RWeick/REF1256-N64-GameBooster-Clone/REF1256 Clone.kicad_pcb

## KiCad design REF1256 Clone.kicad_pcb (2024-07-02)

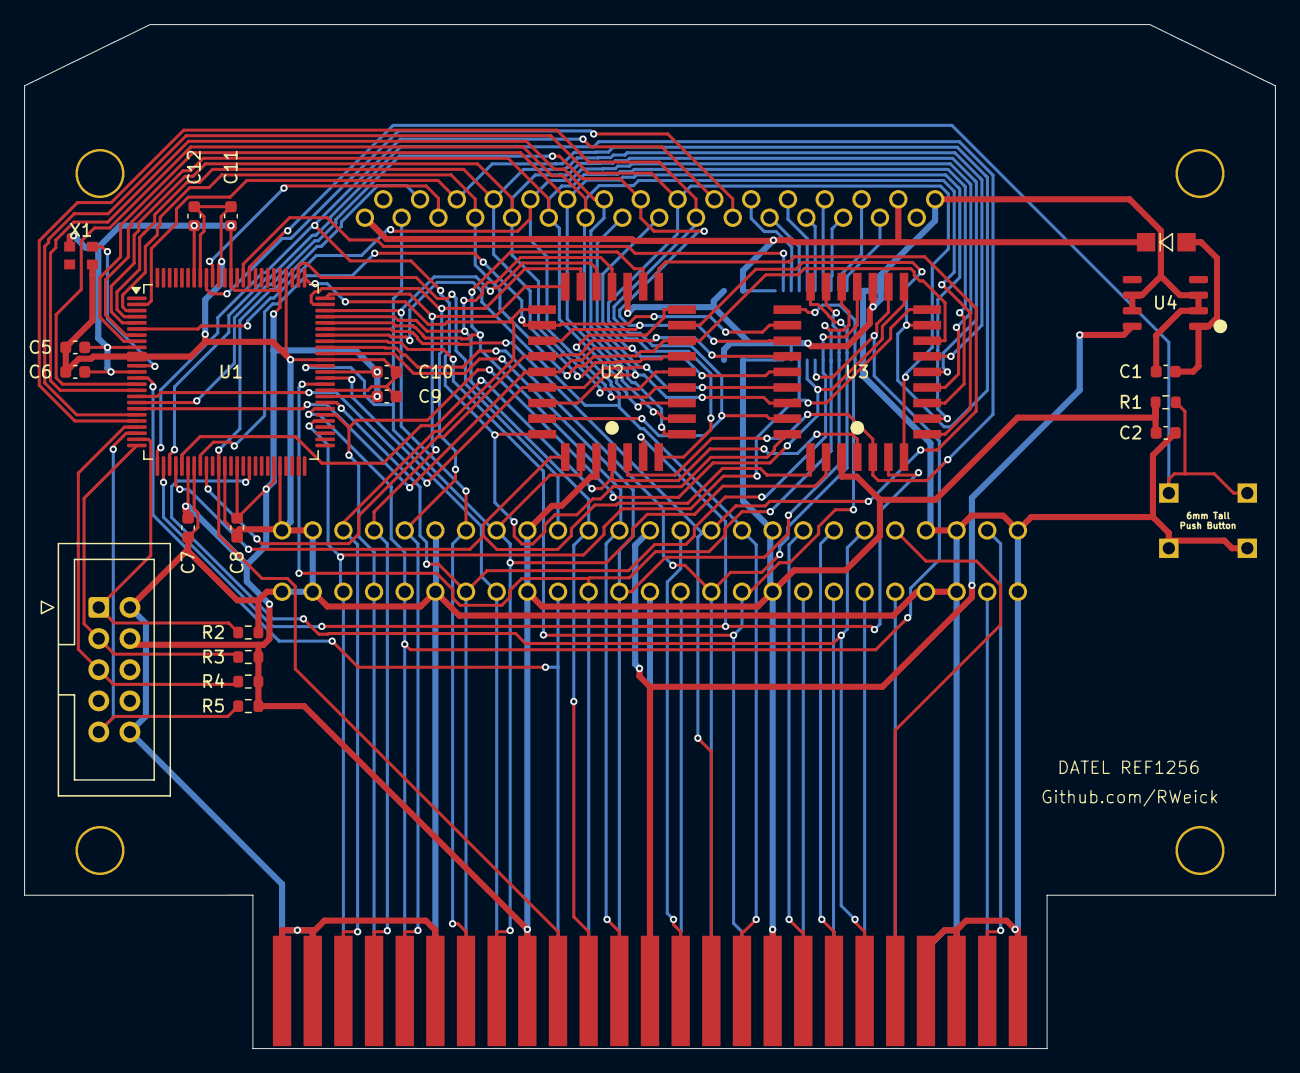
[picture p2: board REF1256 Clone.kicad_pcb from above]

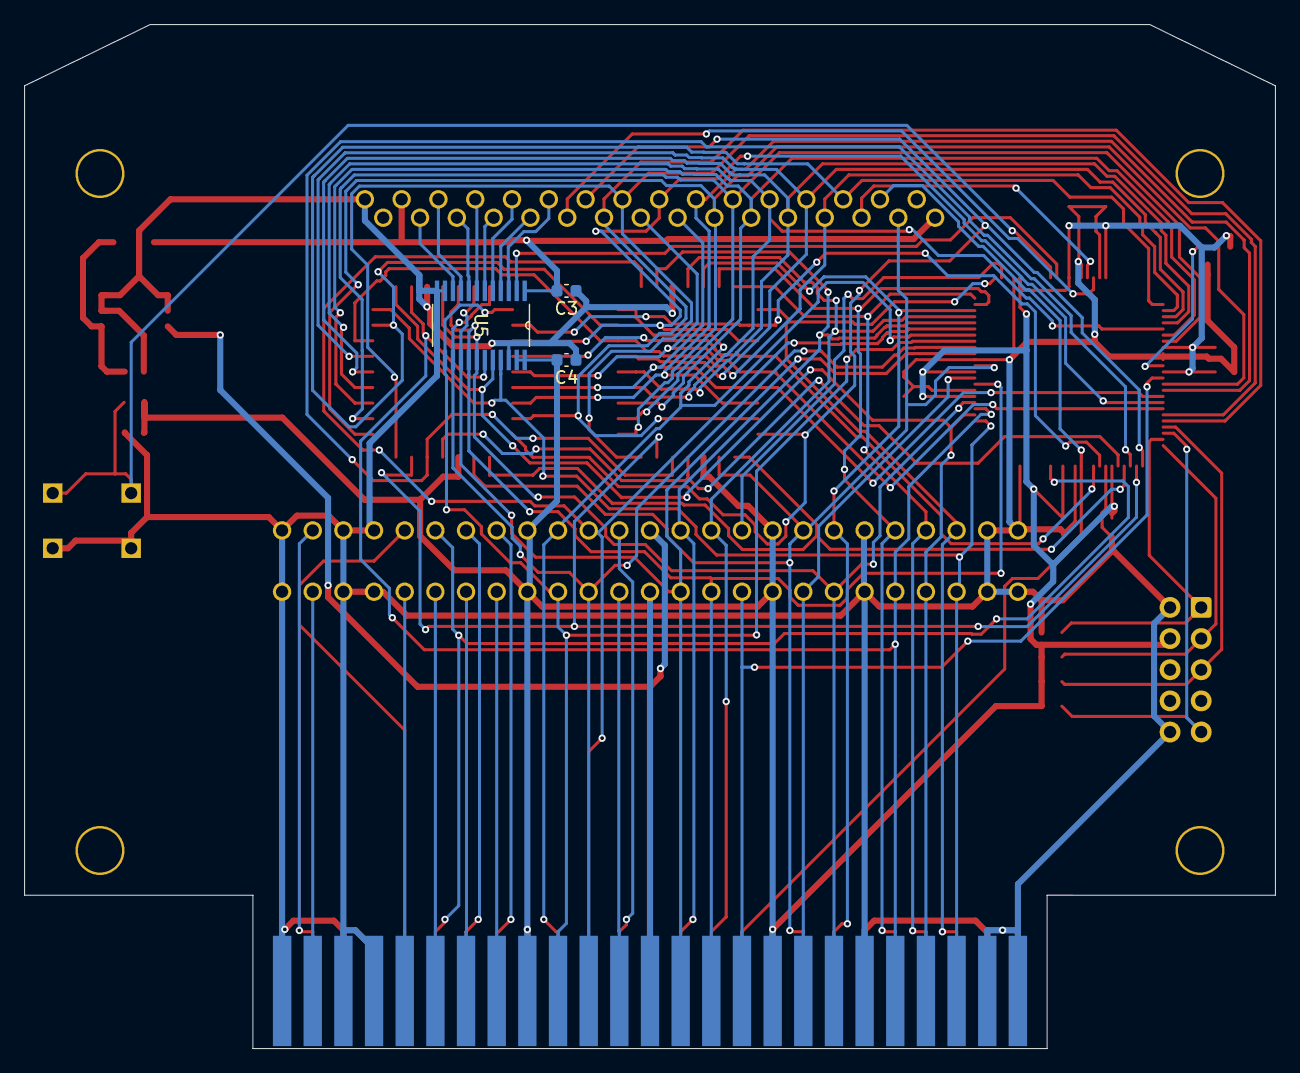
[picture p3: board REF1256 Clone.kicad_pcb from below]

Board: 2 copper layers, 102.0 x 83.5 mm, 30 parts (3 on the bottom side), 77 nets.

Parts:
C1, C2, C5, C6, C7, C8, C9, C10, C11, C12: 100 nF; C_0603_1608Metric
C3, C4: 100n; C_0603_1608Metric
D1: D_Small; Diode
Holes: Drill Holes
J1: Gameboy Cartridge Connector; Gameboy Slot
J2: N64 Cartridge Slot; Cartridge Slot
J3: Edge_Connector; Bottom Edge Connector
J4: Conn_02x05_Odd_Even; IDC-Header_2x05_P2.54mm_Vertical
R1, R2, R3, R4, R5: 10K Ohm; R_0603_1608Metric
SW1: SW_Push; 6mm Push Button
U1: EPM570T100; LQFP-100_14x14mm_P0.5mm
U2, U3: SST28LF040; PLCC32
U4: LM78L05_SO8; LM7805
U5: SN74LVC4245A
X1: ASCO; 50 MHz Crystal

Connections:
+3V3: C2.1, C4.2, C5.2, C6.2, C7.2, C8.2, C9.1, C10.1, C11.1, C12.1, J2.9 (3.3V), J2.17 (3.3V), J2.34 (3.3V), J2.42 (3.3V), J3.9 (3.3V), J3.17 (3.3V), J3.34 (3.3V), J3.42 (3.3V), J4.4, R1.1, R3.2, R4.2, R5.2, U1.9 (VCCIO1), U1.13 (VCCINT), U1.31 (VCCIO1), U1.39 (VCCINT), U1.45 (VCCIO1), U1.59 (VCCIO2), U1.63 (VCCINT), U1.80 (VCCIO2), U1.88 (VCCINT), U1.94 (VCCIO2), U2.32 (VCC), U3.32 (VCC), U5.23 (VCCB), U5.24 (VCCB), X1.4 (VDD)
/5V.VCC: C3.2, D1.1 (K), J1.1 (+5V), J1.30 (Reset), U5.1 (VCCA)
/5V.VOUT: C1.2, D1.2 (A), U4.1 (OUT)
/12V_Front: J2.13 (12V), J3.13 (12V), U4.8 (IN)
/12V_Rear: J2.38 (12V), J3.38 (12V)
/A0: J1.6 (A0), U1.2 (IO1_2), U2.12 (A0), U3.12 (A0)
/A1: J1.7 (A1), U1.3 (IO1_3), U2.11 (A1), U3.11 (A1)
/A2: J1.8 (A2), U1.4 (IO1_4), U2.10 (A2), U3.10 (A2)
/A3: J1.9 (A3), U1.5 (IO1_5), U2.9 (A3), U3.9 (A3)
/A4: J1.10 (A4), U1.6 (IO1_6), U2.8 (A4), U3.8 (A4)
/A5: J1.11 (A5), U1.7 (IO1_7), U2.7 (A5), U3.7 (A5)
/A6: J1.12 (A6), U1.8 (IO1_8), U2.6 (A6), U3.6 (A6)
/A7: J1.13 (A7), U1.15 (IO1_15), U2.5 (A7), U3.5 (A7)
/A8: J1.14 (A8), U1.16 (IO1_16), U2.27 (A8), U3.27 (A8)
/A9: J1.15 (A9), U1.17 (IO1_17), U2.26 (A9), U3.26 (A9)
/A10: J1.16 (A10), U1.18 (IO1_18), U2.23 (A10), U3.23 (A10)
/A11: J1.17 (A11), U1.19 (IO1_19), U2.25 (A11), U3.25 (A11)
/A12: J1.18 (A12), U1.20 (IO1_20), U2.4 (A12), U3.4 (A12)
/A13: J1.19 (A13), U1.21 (IO1_21), U2.28 (A13), U3.28 (A13)
/A14: J1.20 (A14), U1.26 (IO1_26), U2.29 (A14), U3.29 (A14)
/A15: U1.27 (IO1_27), U2.3 (A15), U3.3 (A15)
/A16: U1.28 (IO1_28), U2.2 (A16), U3.2 (A16)
/A17: U1.29 (IO1_29), U2.30 (A17), U3.30 (A17)
/A18: U1.30 (IO1_30), U2.1 (A18), U3.1 (A18)
/AD0: J2.28 (AD0), J3.28 (AD0), U1.55 (IO2_55), U3.13 (Ad8), U5.21 (B1)
/AD0.5V: J1.22 (Data_0), U5.3 (A1)
/AD1: J2.29 (AD1), J3.29 (AD1), U1.56 (IO2_56), U3.14 (Ad9), U5.20 (B2)
/AD1.5V: J1.23 (Data_1), U5.4 (A2)
/AD2: J2.30 (AD2), J3.30 (AD2), U1.57 (IO2_57), U3.15 (Ad10), U5.19 (B3)
/AD2.5V: J1.24 (Data_2), U5.5 (A3)
/AD3: J2.32 (AD3), J3.32 (AD3), U1.58 (IO2_58), U3.17 (Ad11), U5.18 (B4)
/AD3.5V: J1.25 (Data_3), U5.6 (A4)
/AD4: J2.36 (AD4), J3.36 (AD4), U1.61 (IO2_61), U3.18 (Ad12), U5.17 (B5)
/AD4.5V: J1.26 (Data_4), U5.7 (A5)
/AD5: J2.37 (AD5), J3.37 (AD5), U1.66 (IO2_66), U3.19 (Ad13), U5.16 (B6)
/AD5.5V: J1.27 (Data_5), U5.8 (A6)
/AD6: J2.40 (AD6), J3.40 (AD6), U1.67 (IO2_67), U3.20 (Ad14), U5.15 (B7)
/AD6.5V: J1.28 (Data_6), U5.9 (A7)
/AD7: J2.41 (AD7), J3.41 (AD7), U1.68 (IO2_68), U3.21 (Ad15), U5.14 (B8)
/AD7.5V: J1.29 (Data_7), U5.10 (A8)
/AD8: J2.16 (AD8), J3.16 (AD8), U1.69 (IO2_69), U2.13 (Ad0)
/AD9: J2.15 (AD9), J3.15 (AD9), U1.70 (IO2_70), U2.14 (Ad1)
/AD10: J2.12 (AD10), J3.12 (AD10), U1.71 (IO2_71), U2.15 (Ad2)
/AD11: J2.11 (AD11), J3.11 (AD11), U1.72 (IO2_72), U2.17 (Ad3)
/AD12: J2.7 (AD12), J3.7 (AD12), U1.73 (IO2_73), U2.18 (Ad4)
/AD13: J2.5 (AD13), J3.5 (AD13), U1.74 (IO2_74), U2.19 (Ad5)
/AD14: J2.4 (AD14), J3.4 (AD14), U1.75 (IO2_75), U2.20 (Ad6)
/AD15: J2.3 (AD15), J3.3 (AD15), U1.76 (IO2_76), U2.21 (Ad7)
/ALE_H: J2.35 (ALE_H), J3.35 (ALE_H), U1.14 (IO1_14/GCLK1)
/ALE_L: J2.33 (ALE_L), J3.33 (ALE_L), U1.62 (IO2_62/GCLK2)
/Button: R1.2, SW1.2, U1.85 (IO2_85)
/CIC.11: J2.19 (CIC_11), J3.19 (CIC_11)
/CIC.14: J2.43 (CIC_14), J3.43 (CIC_14)
/CIC.15: J2.18 (CIC_15), J3.18 (CIC_15)
/CLK: U1.12 (IO1_12/GCLK0), X1.3 (OUT)
/Chip_Enable: U1.33 (IO1_33), U2.22 (CE#), U3.22 (CE#)
/Gameboy.A15: J1.21 (A15), U1.92 (IO2_92)
/Gameboy.CS: J1.5 (CS), U1.91 (IO2_91)
/LAUDIO: J2.24 (LAUDIO), J3.24 (LAUDIO)
/Output_Enable: U1.34 (IO1_34), U2.24 (OE#), U3.24 (OE#)
/RAUDIO: J2.49 (RAUDIO), J3.49 (RAUDIO)
/S_DAT: J2.21 (EEPROM_DAT), J3.21 (EEPROM_DAT)
/Shift.Dir: U1.86 (IO2_86), U5.2 (DIR)
/TCK: J4.1, R2.1, U1.24 (TCK)
/TDI: J4.9, R5.1, U1.23 (TDI)
/TDO: J4.3, R3.1, U1.25 (TDO)
/TMS: J4.5, R4.1, U1.22 (TMS)
/UNUSED_Front: J2.14 (12V), J3.14 (12V)
/UNUSED_Rear: J2.39 (12V), J3.39 (12V)
/Video.Sync: J2.46 (VIDEO_SYNC), J3.46 (VIDEO_SYNC)
//COLD_RESET: J2.20 (/ColdReset), J3.20 (/ColdReset), U1.41 (IO1_41)
//INT1: J2.44 (/INT1), J3.44 (/INT1)
//NMI: J2.45 (/NMI), J3.45 (/NMI)
//read_bottom: J1.4 (Read), J3.10 (/RD), U1.36 (IO1_36)
//read_top: J2.10 (/RD), U1.77 (IO2_77)
//write: J1.3 (Write), J2.8 (/WR), J3.8 (/WR), U1.64 (IO2_64/GCLK3), U2.31 (WE#), U3.31 (WE#)
GND: C1.1, C2.2, C3.1, C4.1, C5.1, C6.1, C7.1, C8.1, C9.2, C10.2, C11.2, C12.2, J1.32 (GND), J2.1 (GND), J2.2 (GND), J2.6 (GND), J2.22 (GND), J2.23 (GND), J2.25 (GND), J2.26 (GND), J2.27 (GND), J2.31 (GND), J2.47 (GND), J2.48 (GND), J2.50 (GND), J3.1 (GND), J3.2 (GND), J3.6 (GND), J3.22 (GND), J3.23 (GND), J3.25 (GND), J3.26 (GND), J3.27 (GND), J3.31 (GND), J3.47 (GND), J3.48 (GND), J3.50 (GND), J4.2, J4.10, R2.2, SW1.1, U1.10 (GNDIO), U1.11 (GNDINT), U1.32 (GNDIO), U1.37 (GNDINT), U1.46 (GNDIO), U1.60 (GNDIO), U1.65 (GNDINT), U1.79 (GNDIO), U1.90 (GNDINT), U1.93 (GNDIO), U2.16 (GND), U3.16 (GND), U4.2 (GND), U4.3 (GND), U4.6 (GND), U4.7 (GND), U5.11 (GND), U5.12 (GND), U5.13 (GND), U5.22 (*OE), X1.2 (GND)
